PhamVanDe05/IOT_Clicker/README.md

# Classroom Clicker

Hệ thống trả lời trắc nghiệm trong lớp: sinh viên bấm đáp án trên tag cầm tay, giáo viên xem kết quả cả lớp ngay trên web.

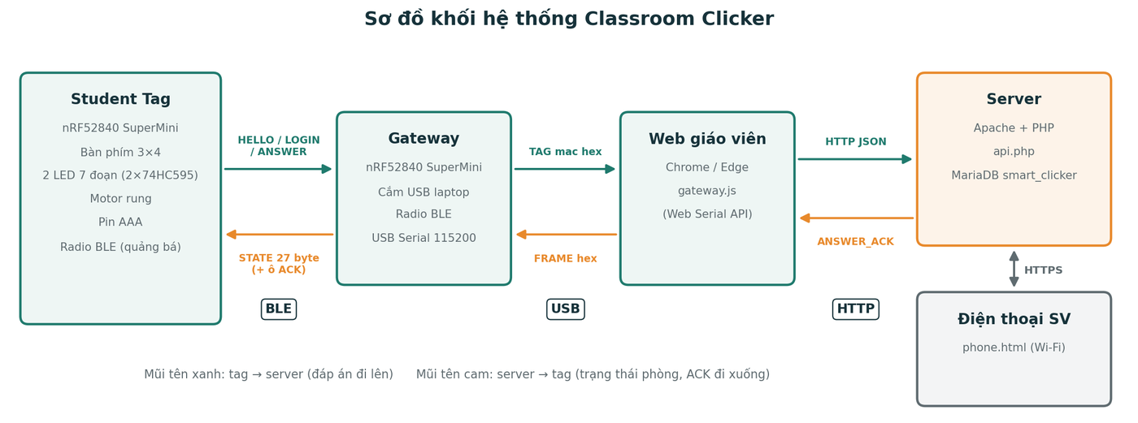
[picture p1: docs/images/so_do_khoi.png]
Sơ đồ khối


## Cách hoạt động

1. Tag bấm **OK** thì phát gói `ANSWER` qua BLE, phát lại liên tục tới khi nhận ACK.
2. Gateway nghe gói, chuyển lên web qua USB Serial.
3. Web (Chrome/Edge, Web Serial) gọi `api.php`.
4. Server **lưu database xong mới trả ACK**; gói trùng không bị ghi 2 lần.
5. ACK đi ngược xuống trong khung `STATE`; tag thấy đúng MAC của mình thì dừng phát và hiện `b=`.

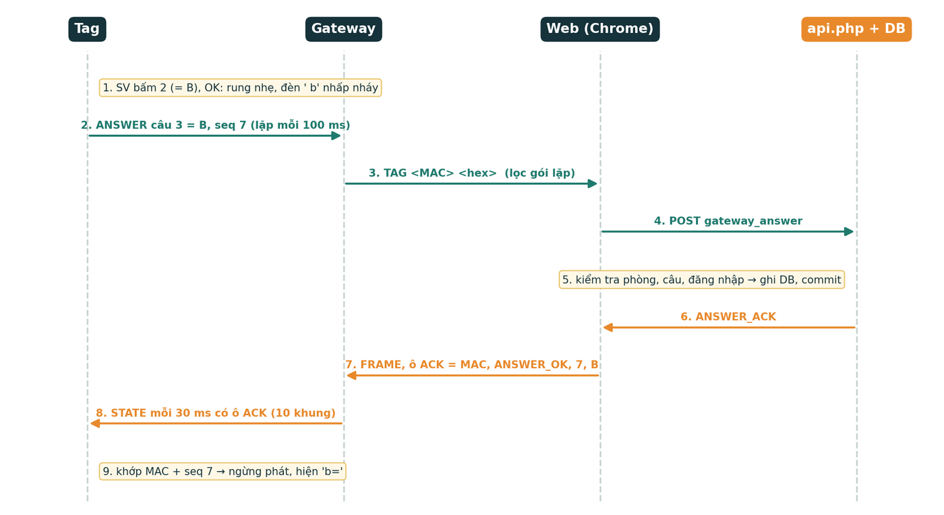
[picture p2: docs/images/so_do_ack.png]
Một câu trả lời và ACK


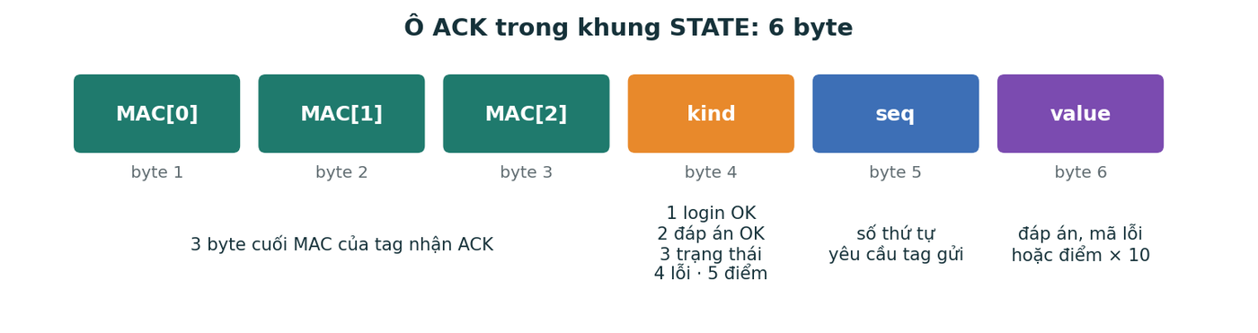
[picture p3: docs/images/ack_6_byte.png]
Ô ACK 6 byte


Định dạng từng byte: [`firmware/ClickerTag/protocol.h`](firmware/ClickerTag/protocol.h).

## Phần cứng

- **Tag:** nRF52840 SuperMini, bàn phím 3×4, 2 LED 7 đoạn qua 2×74HC595, motor rung, pin AAA.
- **Gateway:** nRF52840 SuperMini cắm USB laptop.

<table>
  <tr>
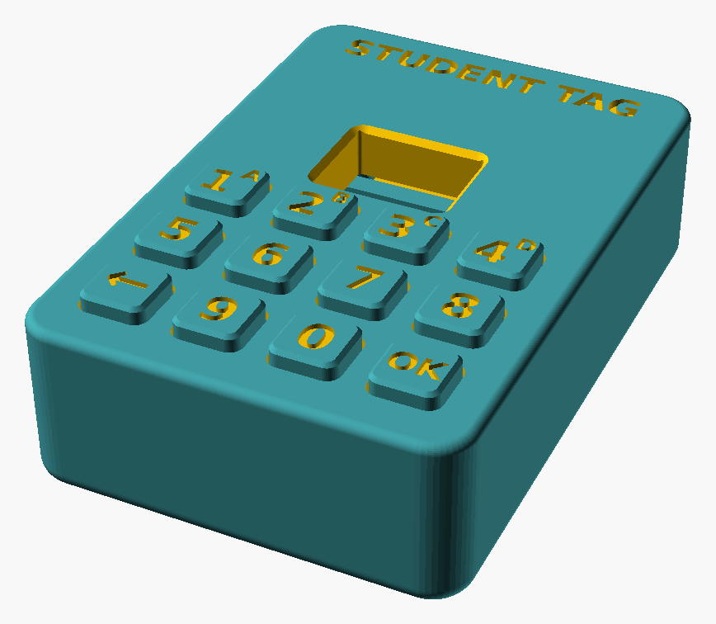
[picture p4: docs/images/tag_case.png]
    <td align="center"><br>Vỏ tag</td>
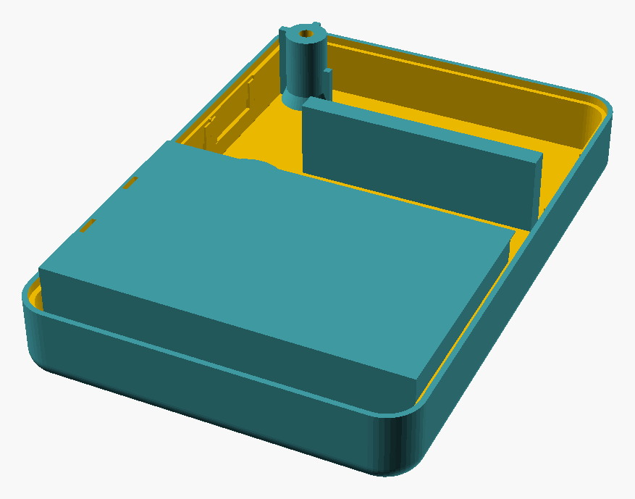
[picture p5: docs/images/tag_bottom.png]
    <td align="center"><br>Đáy tag</td>
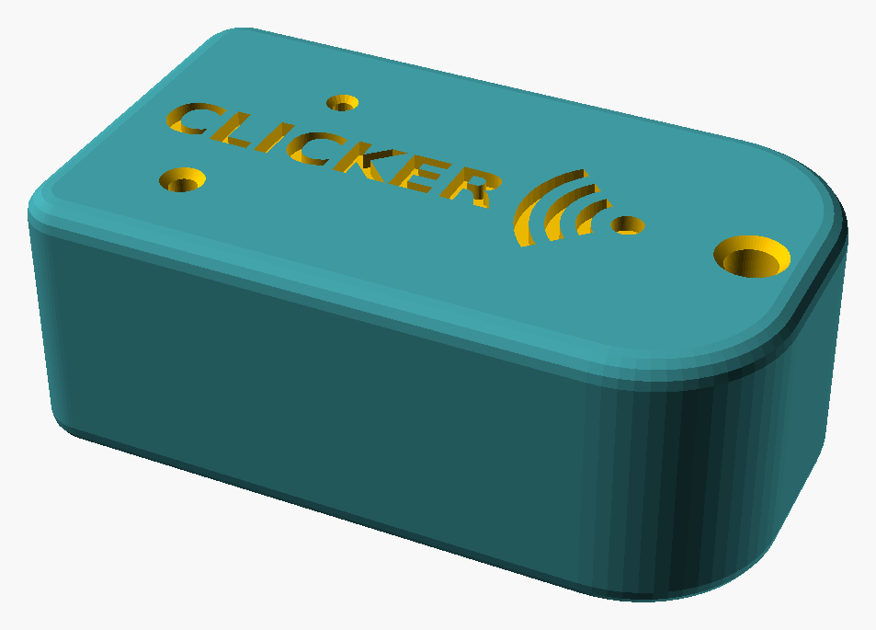
[picture p6: docs/images/gateway_case.png]
    <td align="center"><br>Vỏ gateway</td>
  </tr>
  <tr>
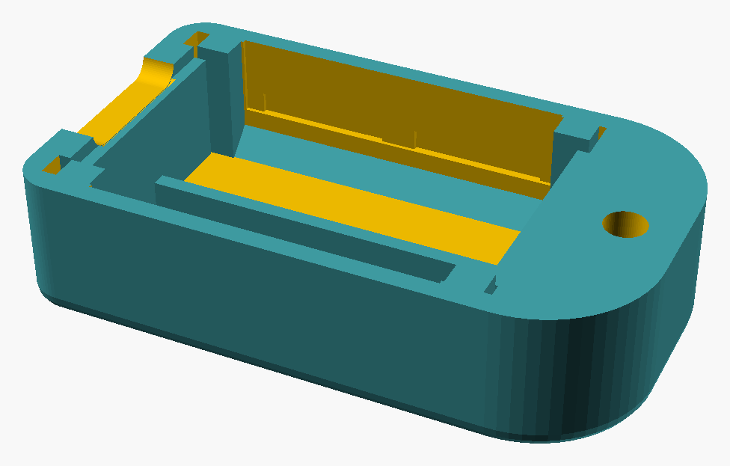
[picture p7: docs/images/gateway_bottom.png]
    <td align="center"><br>Đáy gateway</td>
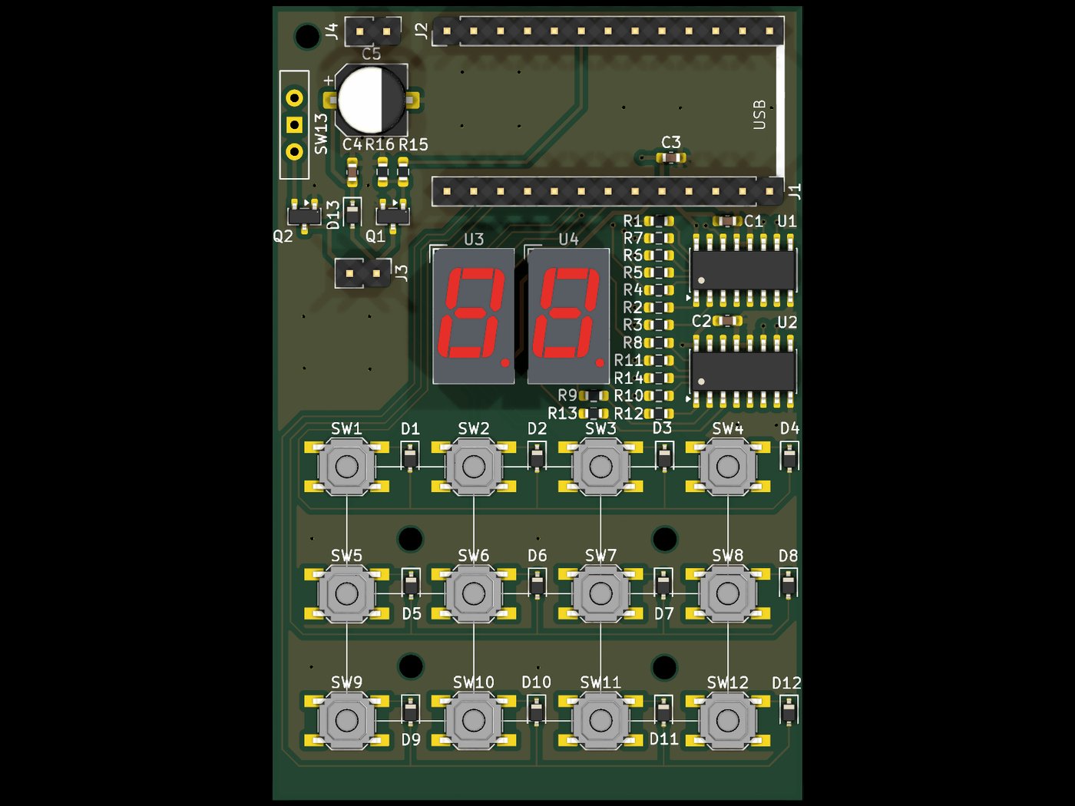
[picture p8: docs/images/pcb_top_3d.jpg]
    <td align="center"><br>PCB tag, mặt trên</td>
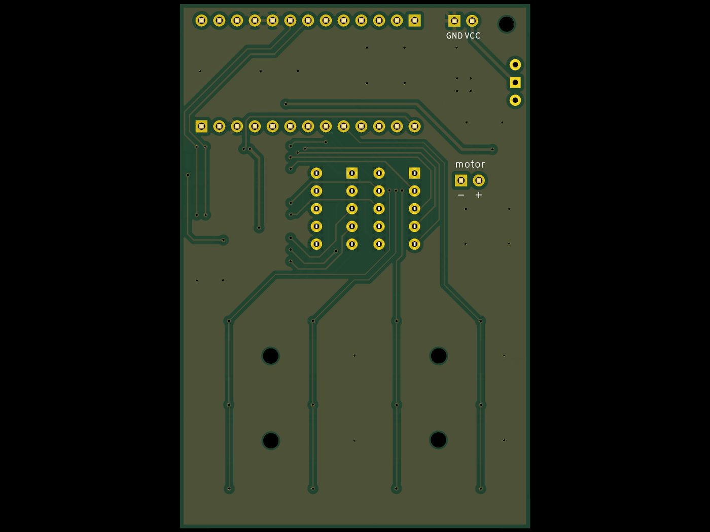
[picture p9: docs/images/pcb_bottom_3d.jpg]
    <td align="center"><br>PCB tag, mặt dưới</td>
  </tr>
  <tr>
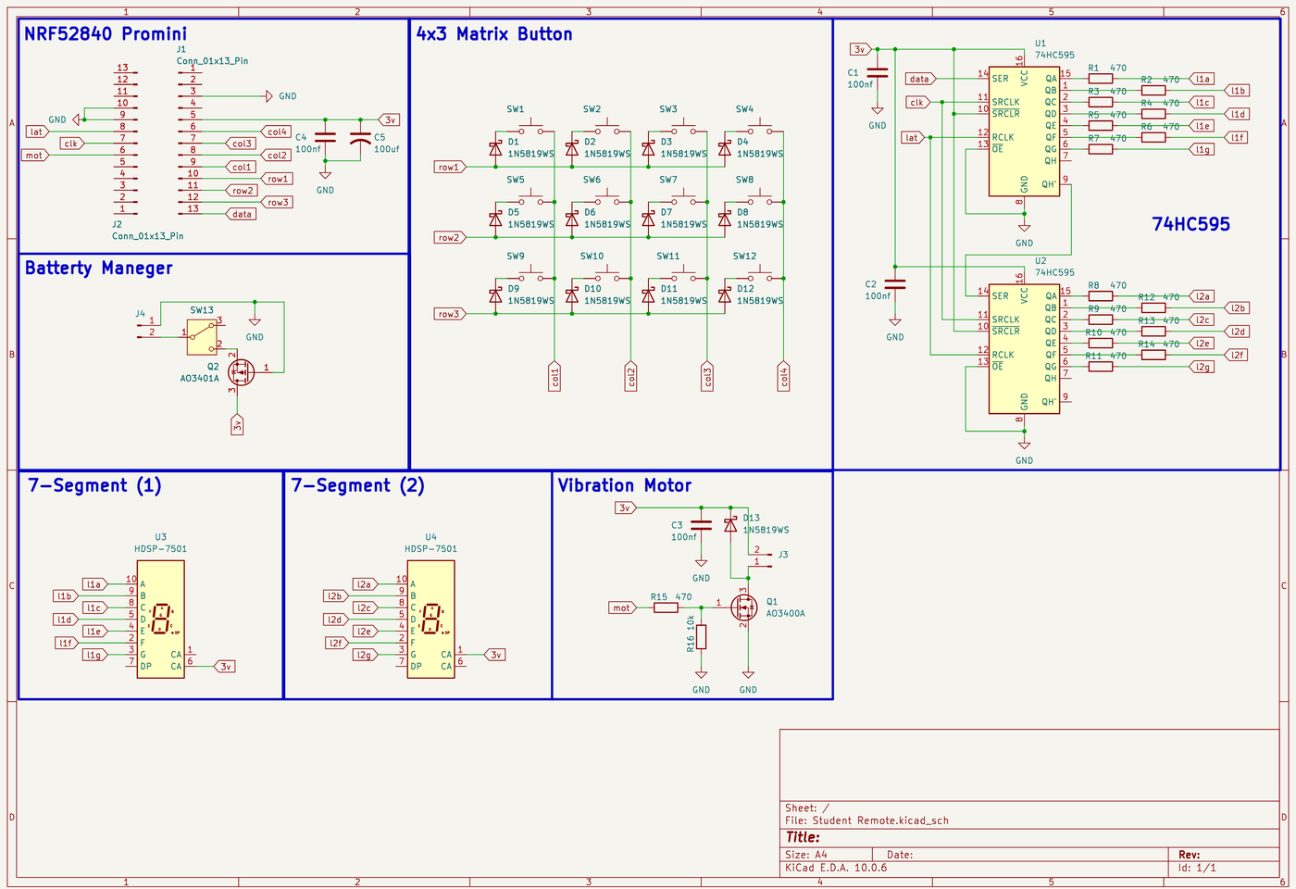
[picture p10: docs/images/schematic.png]
    <td colspan="3" align="center"><br>Sơ đồ nguyên lý</td>
  </tr>
</table>

### Màn hình tag trong một buổi

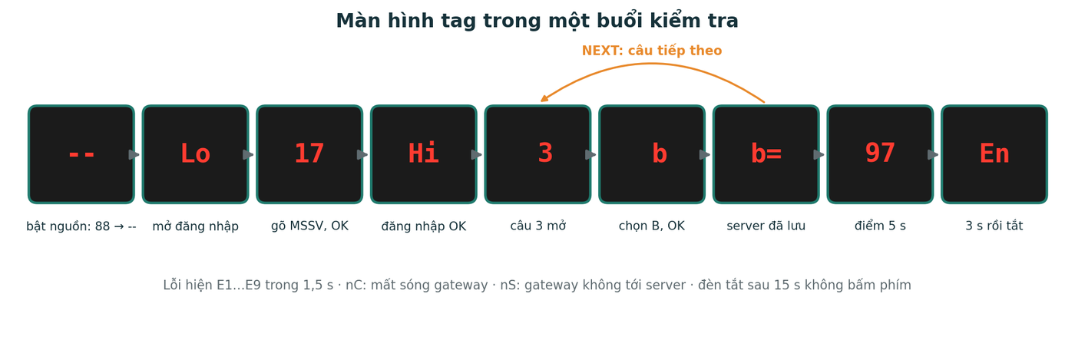
[picture p11: docs/images/luong_man_hinh_tag.png]
Luồng màn hình tag


Bảng mã đèn và mã lỗi đầy đủ: [docs/su_dung.md](docs/su_dung.md).

## Giao diện web

<table>
  <tr>
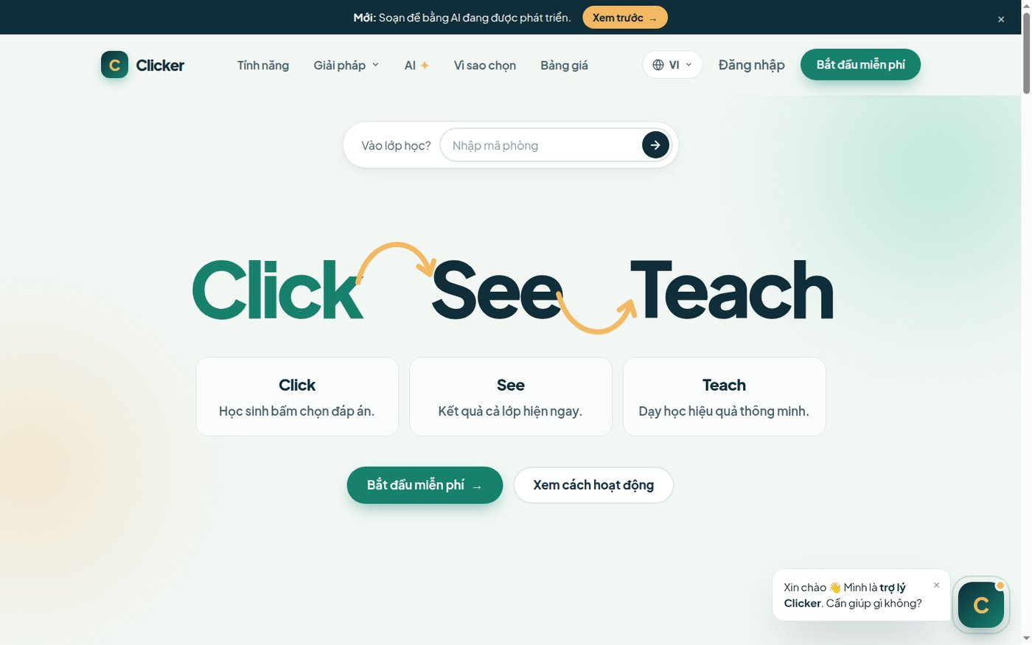
[picture p12: docs/images/landing.jpg]
    <td align="center"><br>Trang chủ</td>
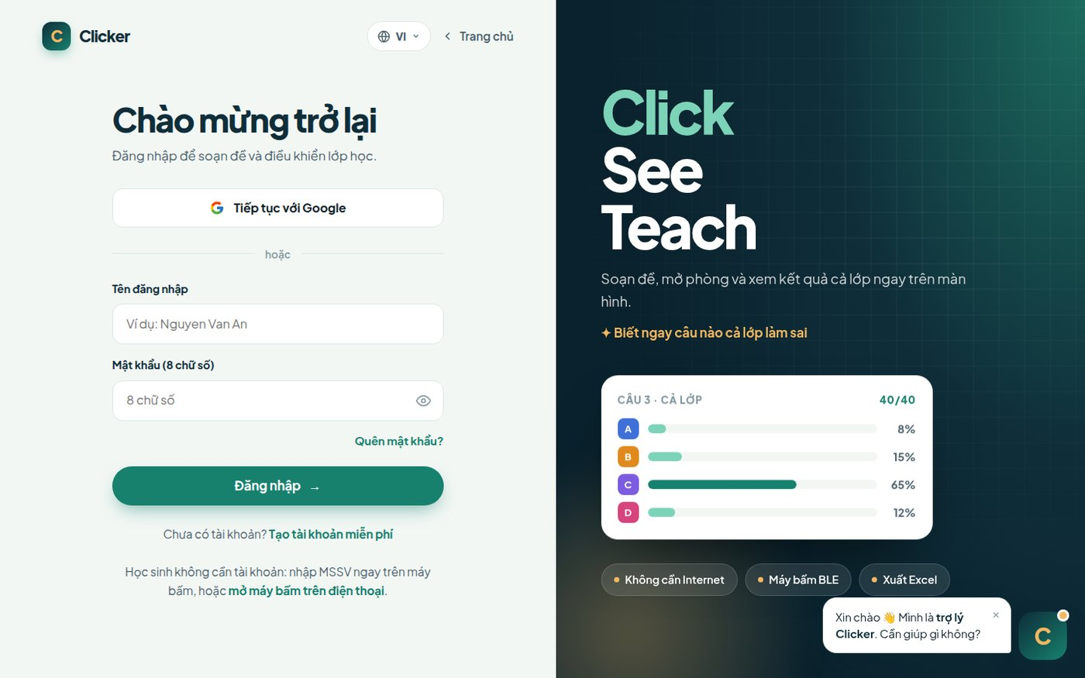
[picture p13: docs/images/login.jpg]
    <td align="center"><br>Đăng nhập</td>
  </tr>
  <tr>
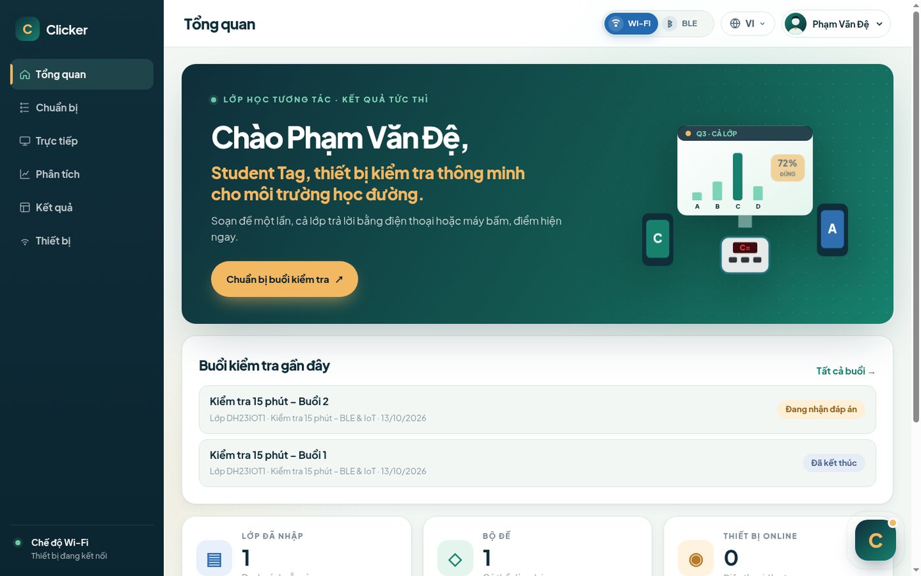
[picture p14: docs/images/overview.jpg]
    <td align="center"><br>Tổng quan</td>
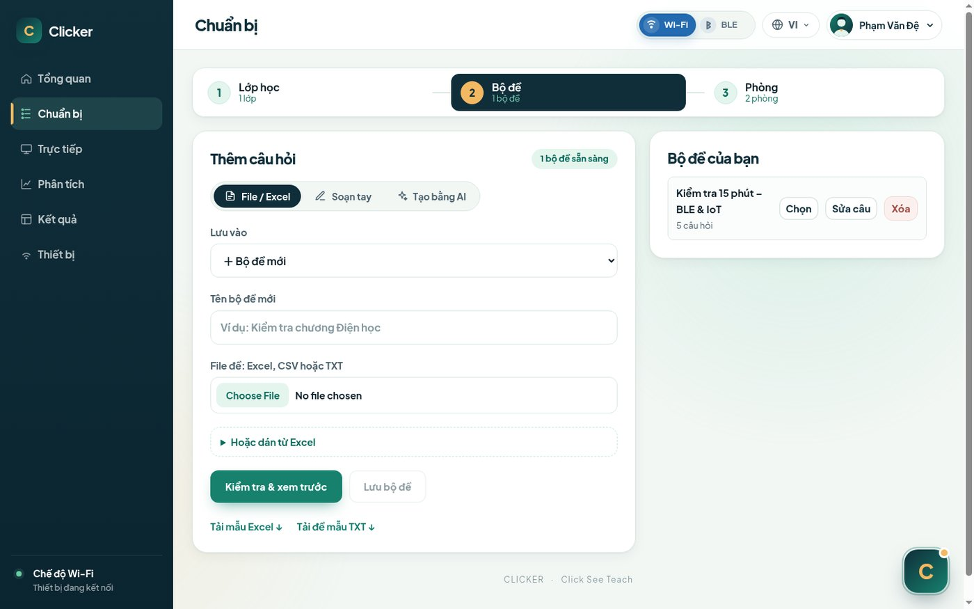
[picture p15: docs/images/prepare.jpg]
    <td align="center"><br>Chuẩn bị lớp và bộ đề</td>
  </tr>
  <tr>
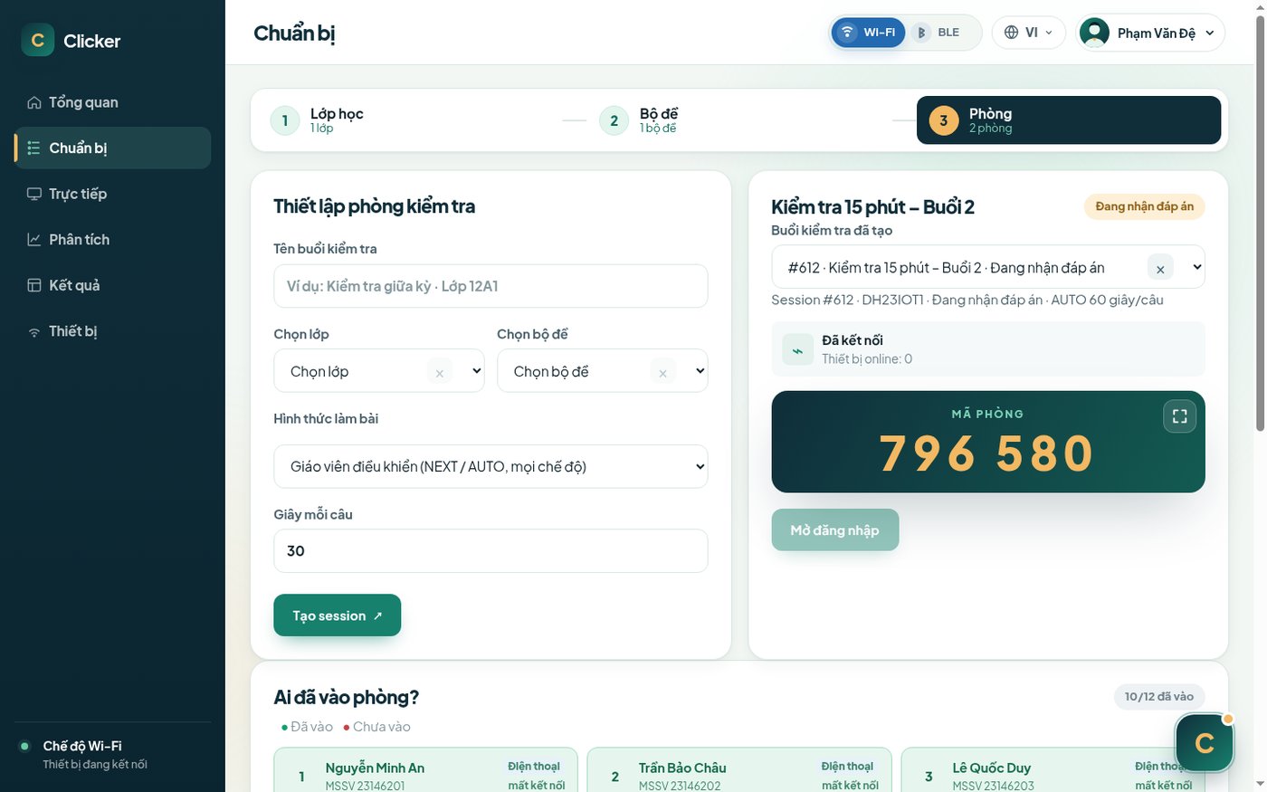
[picture p16: docs/images/room.jpg]
    <td align="center"><br>Tạo phòng, mã phòng</td>
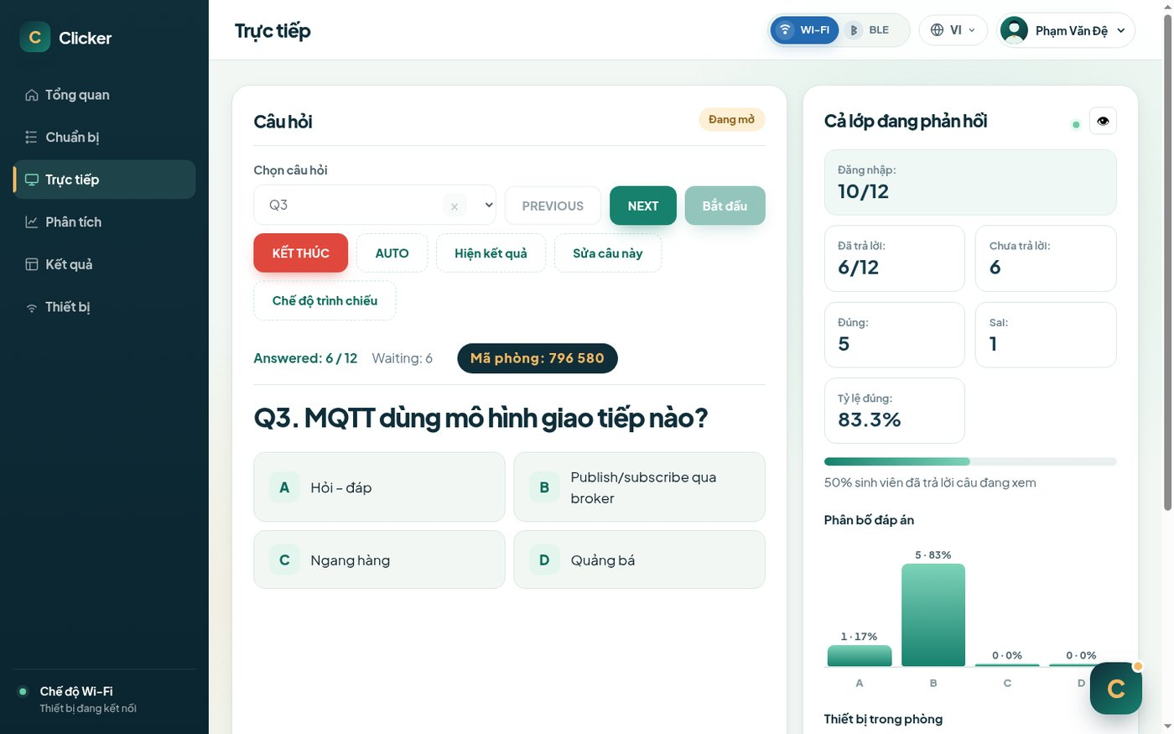
[picture p17: docs/images/live.jpg]
    <td align="center"><br>Trực tiếp: câu hỏi và biểu đồ đáp án</td>
  </tr>
  <tr>
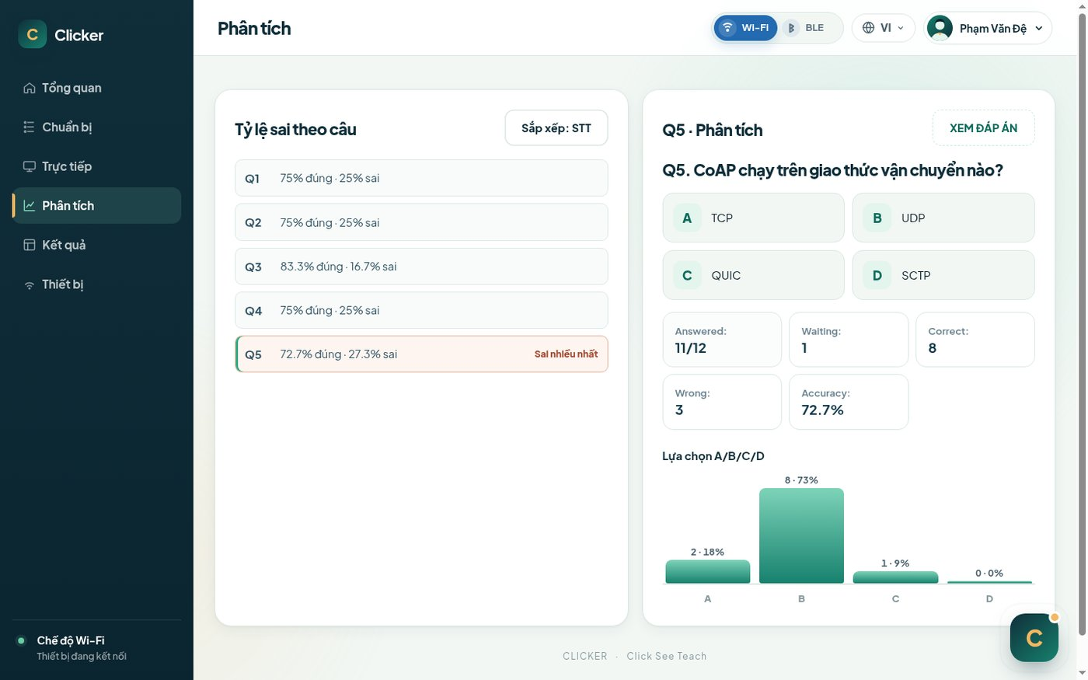
[picture p18: docs/images/analysis-section.jpg]
    <td align="center"><br>Phân tích câu hỏi</td>
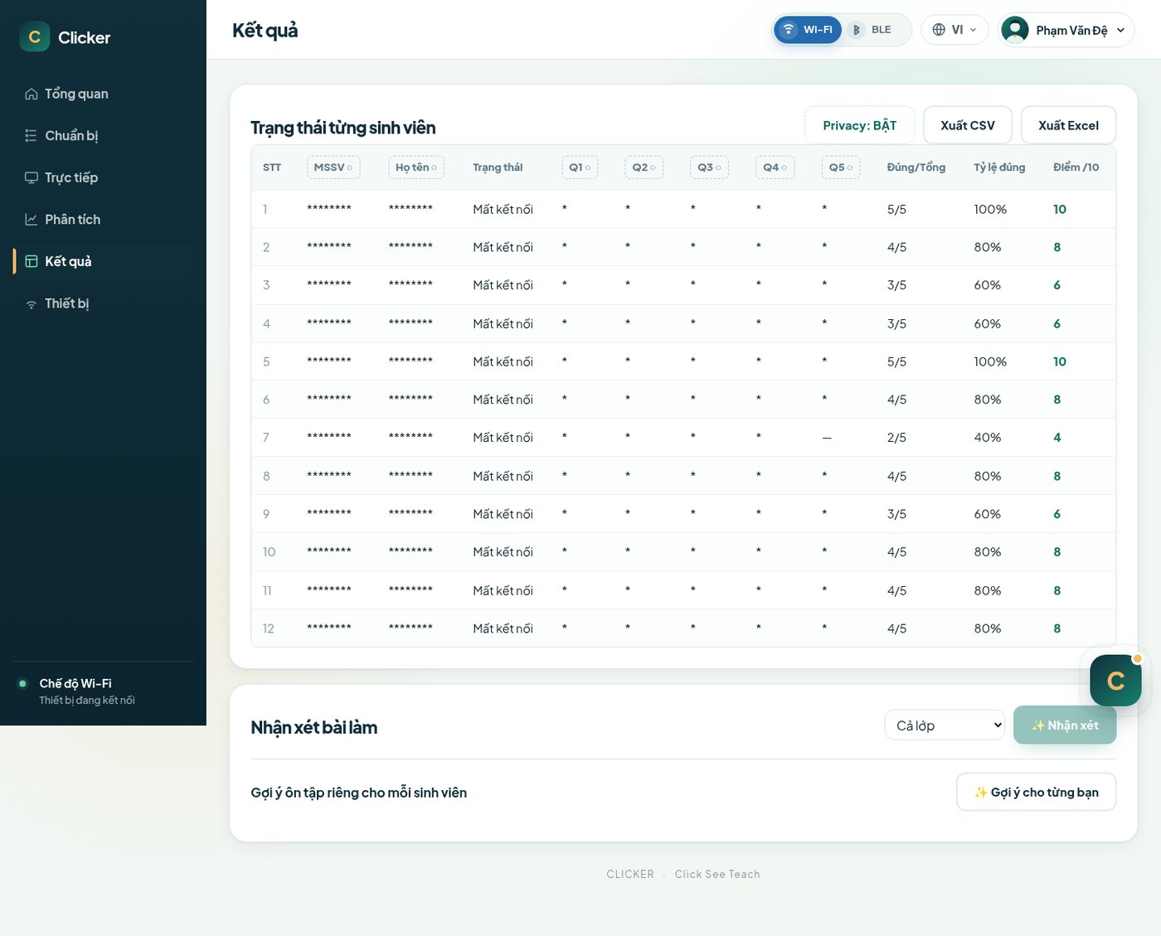
[picture p19: docs/images/results-section.jpg]
    <td align="center"><br>Bảng kết quả</td>
  </tr>
</table>

## Thư mục

| Thư mục | Nội dung |
|---|---|
| `web/` | Web giáo viên và API |
| `schema.sql` | Cấu trúc database |
| `config.example.php` | Mẫu file cấu hình |
| `examples/` | Danh sách lớp và đề mẫu |
| `firmware/ClickerTag/` | Firmware tag sinh viên |
| `firmware/ClickerGateway/` | Firmware gateway cắm USB laptop |
| `hardware/` | PCB (KiCad, Gerber, BOM) và vỏ in 3D tag, gateway |
| `docs/su_dung.md` | Hướng dẫn sử dụng, bảng mã đèn và mã lỗi |

## Cài đặt nhanh

**Server**

1. Import `schema.sql` vào MariaDB.
2. Chép `config.example.php` ra ngoài thư mục web, điền database và khóa; trỏ biến môi trường `CLICKER_CONFIG` tới file đó.
3. Đặt `web/` dưới Apache, mở <http://localhost/clicker/> bằng Chrome hoặc Edge.

**Firmware**: Arduino IDE, core **Adafruit nRF52**, board **Adafruit ItsyBitsy nRF52840 Express**. Nạp `firmware/ClickerTag/` vào tag, `firmware/ClickerGateway/` vào gateway.

Hướng dẫn một buổi kiểm tra: [docs/su_dung.md](docs/su_dung.md).
