PhamVanDe05/IOT_Clicker/web/landing/og.png

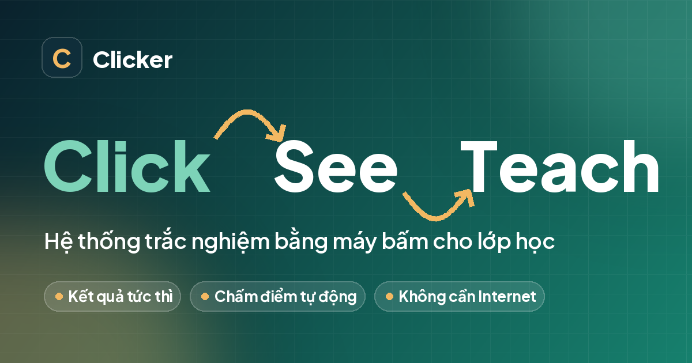
web/landing/og.png
