PhamVanDe05/IOT_Clicker/hardware/pcb/Student Remote.csv

Reference | Qty | Value | DNP | Exclude from BOM | Exclude from Board | Footprint | Datasheet
C1,C2,C3,C4 | 4 | 100nf |  |  |  | Capacitor_SMD:C_0603_1608Metric_Pad1.08x0.95mm_HandSolder | ~
C5 | 1 | 100uf |  |  |  | Capacitor_SMD:CP_Elec_6.3x5.4
D1,D2,D3,D4,D5,D6,D7,D8,D9,D10,D11,D12,D13 | 13 | 1N5819WS |  |  |  | Diode_SMD:D_SOD-323 | https://datasheet.lcsc.com/lcsc/2204281430_Guangdong-Hottech-1N5819WS_C191023.pdf
J1,J2 | 2 | Conn_01x13_Pin |  |  |  | Connector_PinHeader_2.54mm:PinHeader_1x13_P2.54mm_Vertical | ~
J3,J4 | 2 | Conn_01x02_Pin |  |  |  | Connector_PinHeader_2.54mm:PinHeader_1x02_P2.54mm_Vertical | ~
Q1 | 1 | AO3400A |  |  |  | Package_TO_SOT_SMD:SOT-23 | http://www.aosmd.com/pdfs/datasheet/AO3400A.pdf
Q2 | 1 | AO3401A |  |  |  | Package_TO_SOT_SMD:SOT-23 | http://www.aosmd.com/pdfs/datasheet/AO3401A.pdf
R1,R2,R3,R4,R5,R6,R7,R8,R9,R10,R11,R12,R13,R14,R15 | 15 | 470 |  |  |  | Resistor_SMD:R_0603_1608Metric_Pad0.98x0.95mm_HandSolder | ~
R16 | 1 | 10k |  |  |  | Resistor_SMD:R_0603_1608Metric_Pad0.98x0.95mm_HandSolder | ~
SW1,SW2,SW3,SW4,SW5,SW6,SW7,SW8,SW9,SW10,SW11,SW12 | 12 | SW_Push |  |  |  | Button_Switch_SMD:SW_SPST_SKQG_WithStem | ~
SW13 | 1 | SW_Wuerth_450301014042 |  |  |  | Button_Switch_THT:SW_Slide-03_Wuerth-WS-SLTV_10x2.5x6.4_P2.54mm | https://www.we-online.com/components/products/datasheet/450301014042.pdf
U1,U2 | 2 | 74HC595 |  |  |  | Package_SO:SOIC-16_3.9x9.9mm_P1.27mm | http://www.ti.com/lit/ds/symlink/sn74hc595.pdf
U3,U4 | 2 | HDSP-7501 |  |  |  | Display_7Segment:HDSP-A151 | https://docs.broadcom.com/docs/AV02-2553EN
