PhamVanDe05/IOT_Clicker/hardware/case/gateway/step/gateway_lap-rap.step

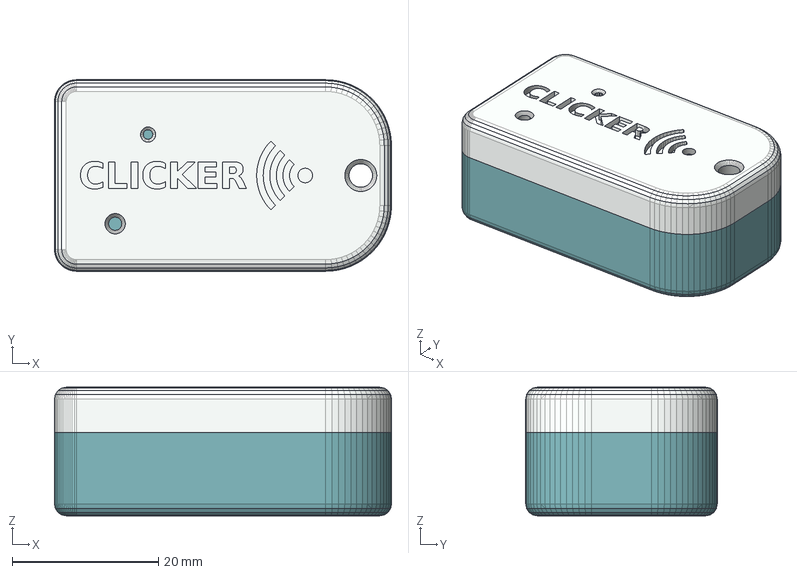
[picture p21: CAD file, 2026-10-13]
hardware/case/gateway/step/gateway_lap-rap.step
46.1 x 26.2 x 17.6 mm
