PhamVanDe05/IOT_Clicker/hardware/case/gateway/stl/nua-tren.stl

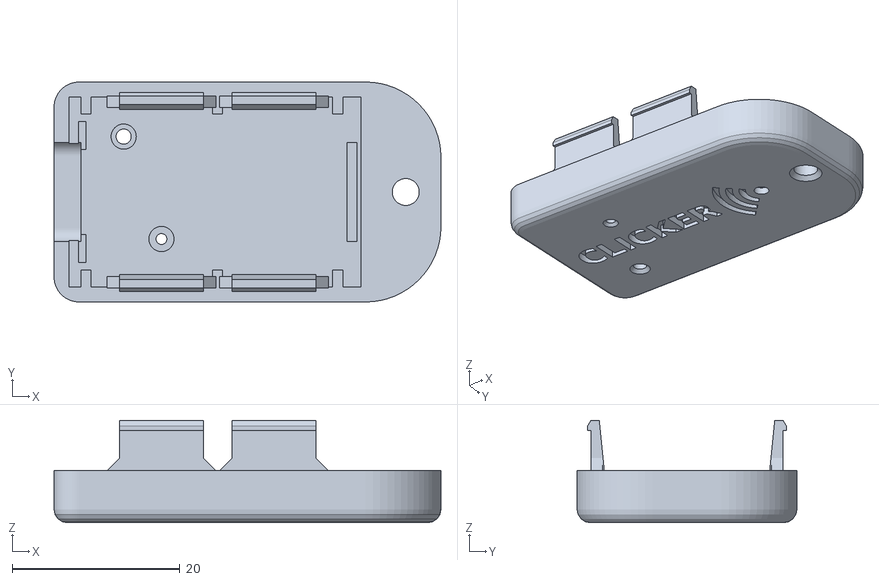
[picture p22: CAD file, 2026-10-13]
hardware/case/gateway/stl/nua-tren.stl
46.1 x 26.2 x 12.2
