PhamVanDe05/IOT_Clicker/hardware/case/tag/step/student_tag_board_kicad.step

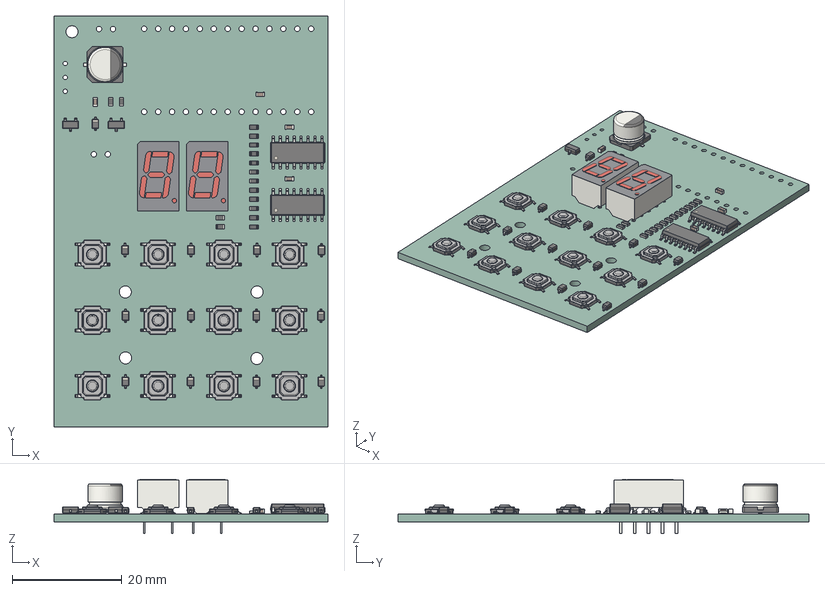
[picture p23: CAD file, 2026-10-10]
hardware/case/tag/step/student_tag_board_kicad.step
50.0 x 75.0 x 9.90 mm
SOT-23 x 2
C_0603_1608Metric x 4
R_0603_1608Metric x 16
CP_Elec_63x54
SOIC-16_3.9x9.9mm_P1.27mm x 2
SW_SPST_SKQG_WithStem x 12
D_SOD-323 x 13
HDSP-A151 x 2
Student Remote_PCB
