PhamVanDe05/IOT_Clicker/hardware/case/tag/stl/phim_2B.stl

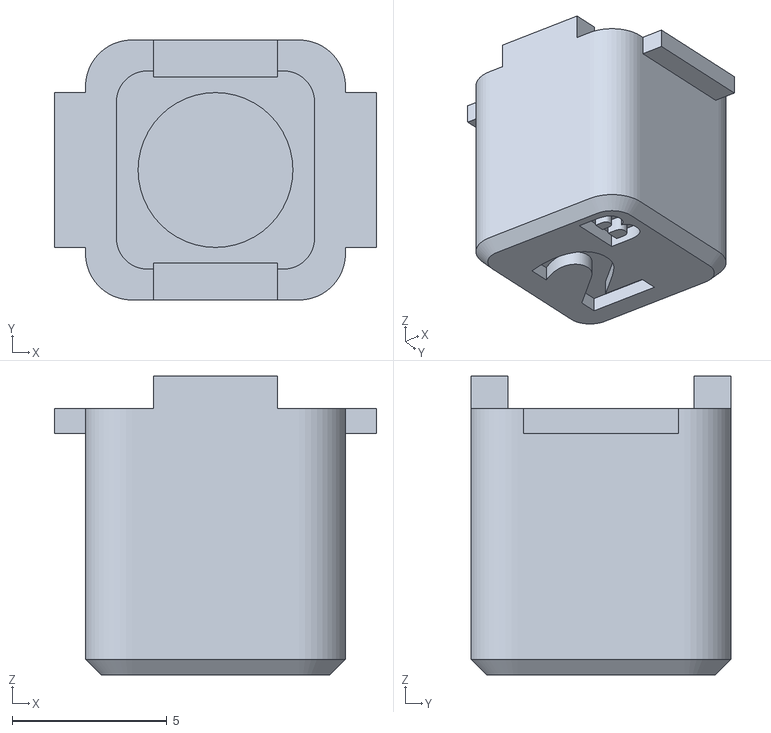
[picture p24: CAD file, 2026-10-10]
hardware/case/tag/stl/phim_2B.stl
10.4 x 8.40 x 9.65
