PhamVanDe05/IOT_Clicker/hardware/case/gateway/stl/nua-duoi.stl

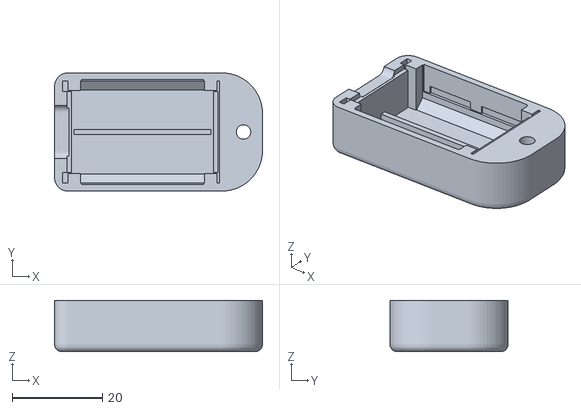
[picture p25: CAD file, 2026-10-10]
hardware/case/gateway/stl/nua-duoi.stl
46.1 x 26.2 x 11.4
