PhamVanDe05/IOT_Clicker/hardware/case/tag/step/student_tag_v3_nap-pin.step

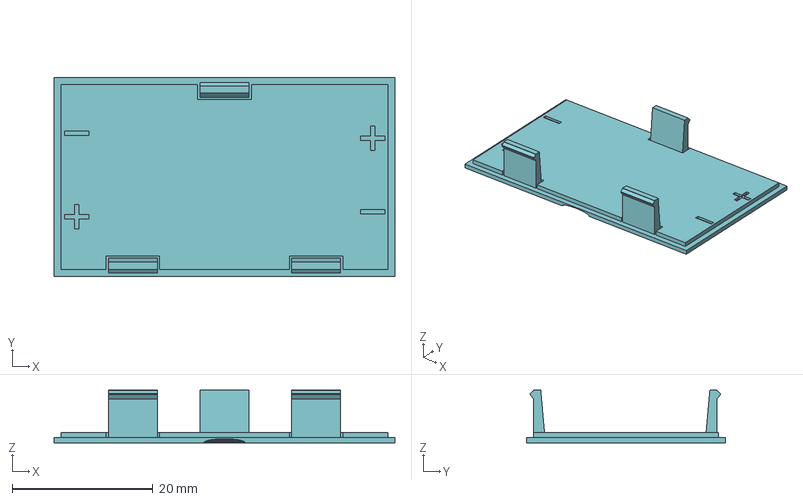
[picture p26: CAD file, 2026-10-10]
hardware/case/tag/step/student_tag_v3_nap-pin.step
48.4 x 28.2 x 7.50 mm
