PhamVanDe05/IOT_Clicker/hardware/case/tag/stl/vo-tren.stl

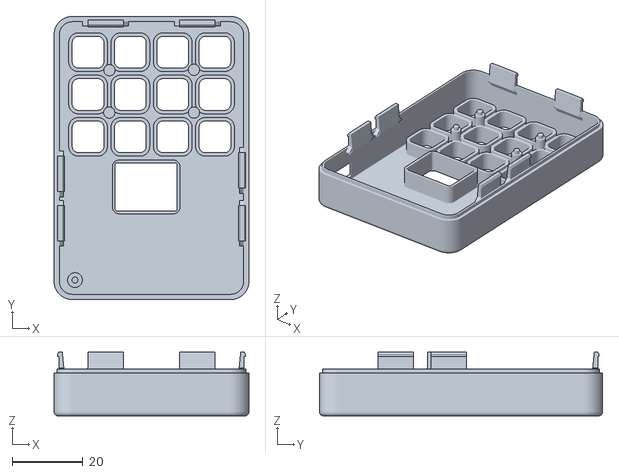
[picture p27: CAD file, 2026-10-10]
hardware/case/tag/stl/vo-tren.stl
55.3 x 80.3 x 18.1
