PhamVanDe05/IOT_Clicker/hardware/case/tag/step/student_tag_v3_vo-duoi.step

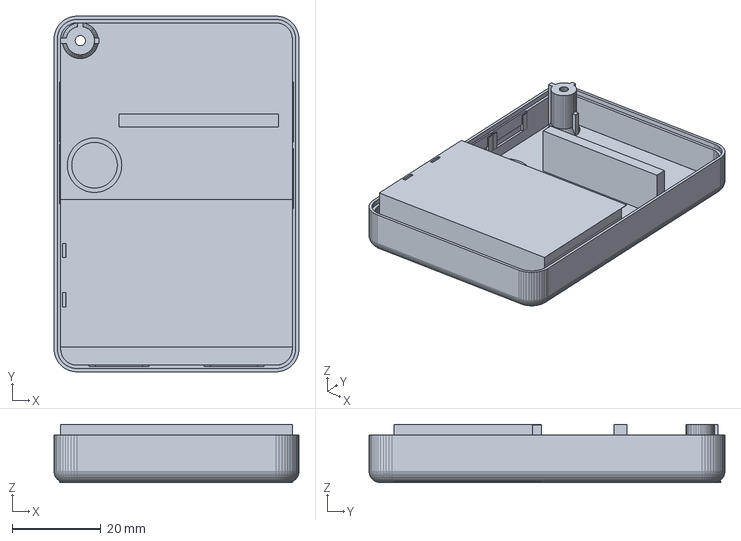
[picture p28: CAD file, 2026-10-10]
hardware/case/tag/step/student_tag_v3_vo-duoi.step
55.3 x 80.3 x 13.1 mm
