PhamVanDe05/IOT_Clicker/hardware/case/tag/step/student_tag_v3_vo-lap-rap.step

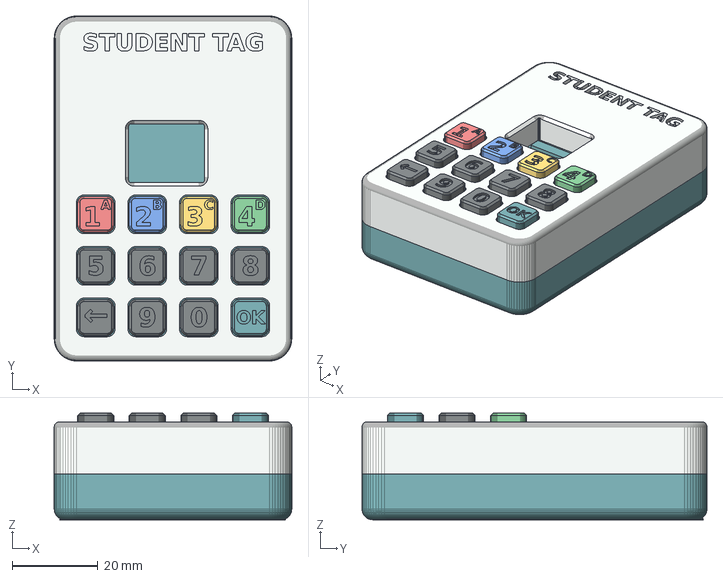
[picture p29: CAD file, 2026-10-10]
hardware/case/tag/step/student_tag_v3_vo-lap-rap.step
55.3 x 80.3 x 24.8 mm
