PhamVanDe05/IOT_Clicker/hardware/case/tag/stl/phim_BACK.stl

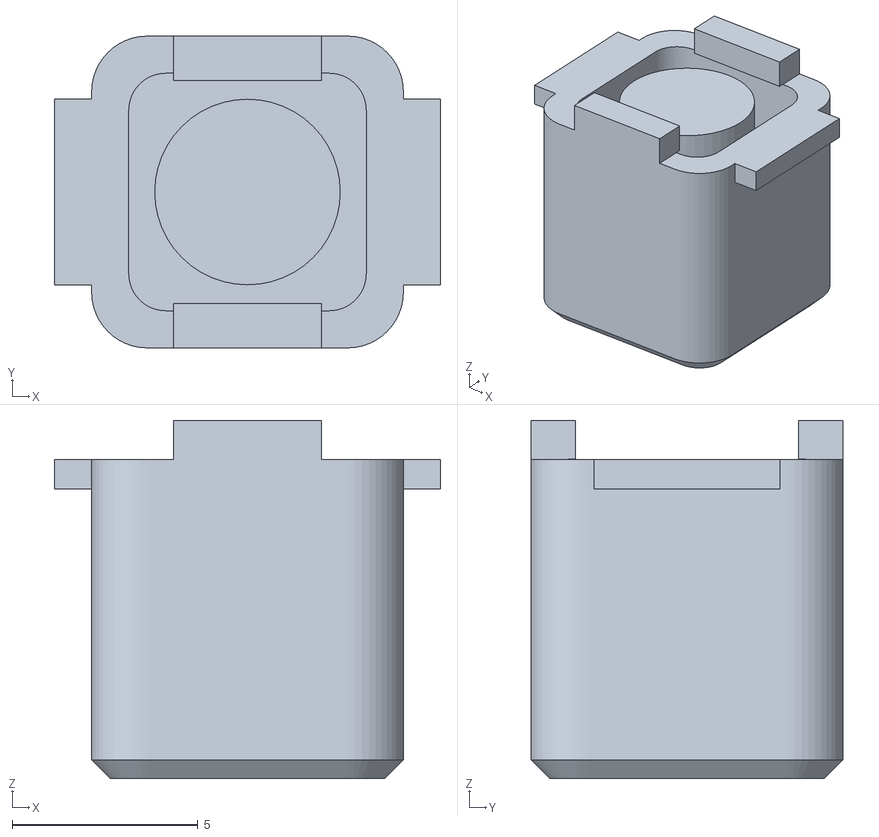
[picture p30: CAD file, 2026-10-10]
hardware/case/tag/stl/phim_BACK.stl
10.4 x 8.40 x 9.65
