PhamVanDe05/IOT_Clicker/hardware/case/tag/step/student_tag_v3_phim.step

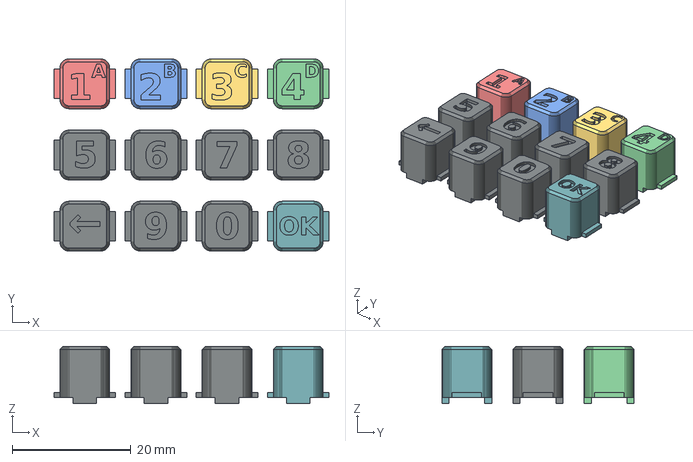
[picture p31: CAD file, 2026-10-10]
hardware/case/tag/step/student_tag_v3_phim.step
46.4 x 32.4 x 9.65 mm
