PhamVanDe05/IOT_Clicker/(list of files, cad)

Other CAD files:
hardware/case/gateway/step/gateway_nua-tren.step
hardware/case/gateway/step/gateway_nua-duoi.step
hardware/case/tag/stl/phim_OK.stl
hardware/case/tag/step/student_tag_v3_vo-tren.step
hardware/case/tag/stl/phim_5.stl
hardware/case/tag/stl/phim_9.stl
hardware/case/tag/stl/phim_8.stl
hardware/case/tag/stl/phim_6.stl
hardware/case/tag/stl/phim_4D.stl
hardware/case/tag/stl/phim_1A.stl
hardware/case/tag/stl/phim_7.stl
hardware/case/tag/stl/phim_0.stl
hardware/case/tag/stl/vo-duoi.stl
hardware/case/tag/stl/phim_3C.stl
hardware/case/tag/stl/nap-pin.stl
