PhamVanDe05/IOT_Clicker/hardware/pcb/Student Remote.kicad_pcb

## KiCad design hardware/pcb/Student Remote.kicad_pcb (2026-10-12)

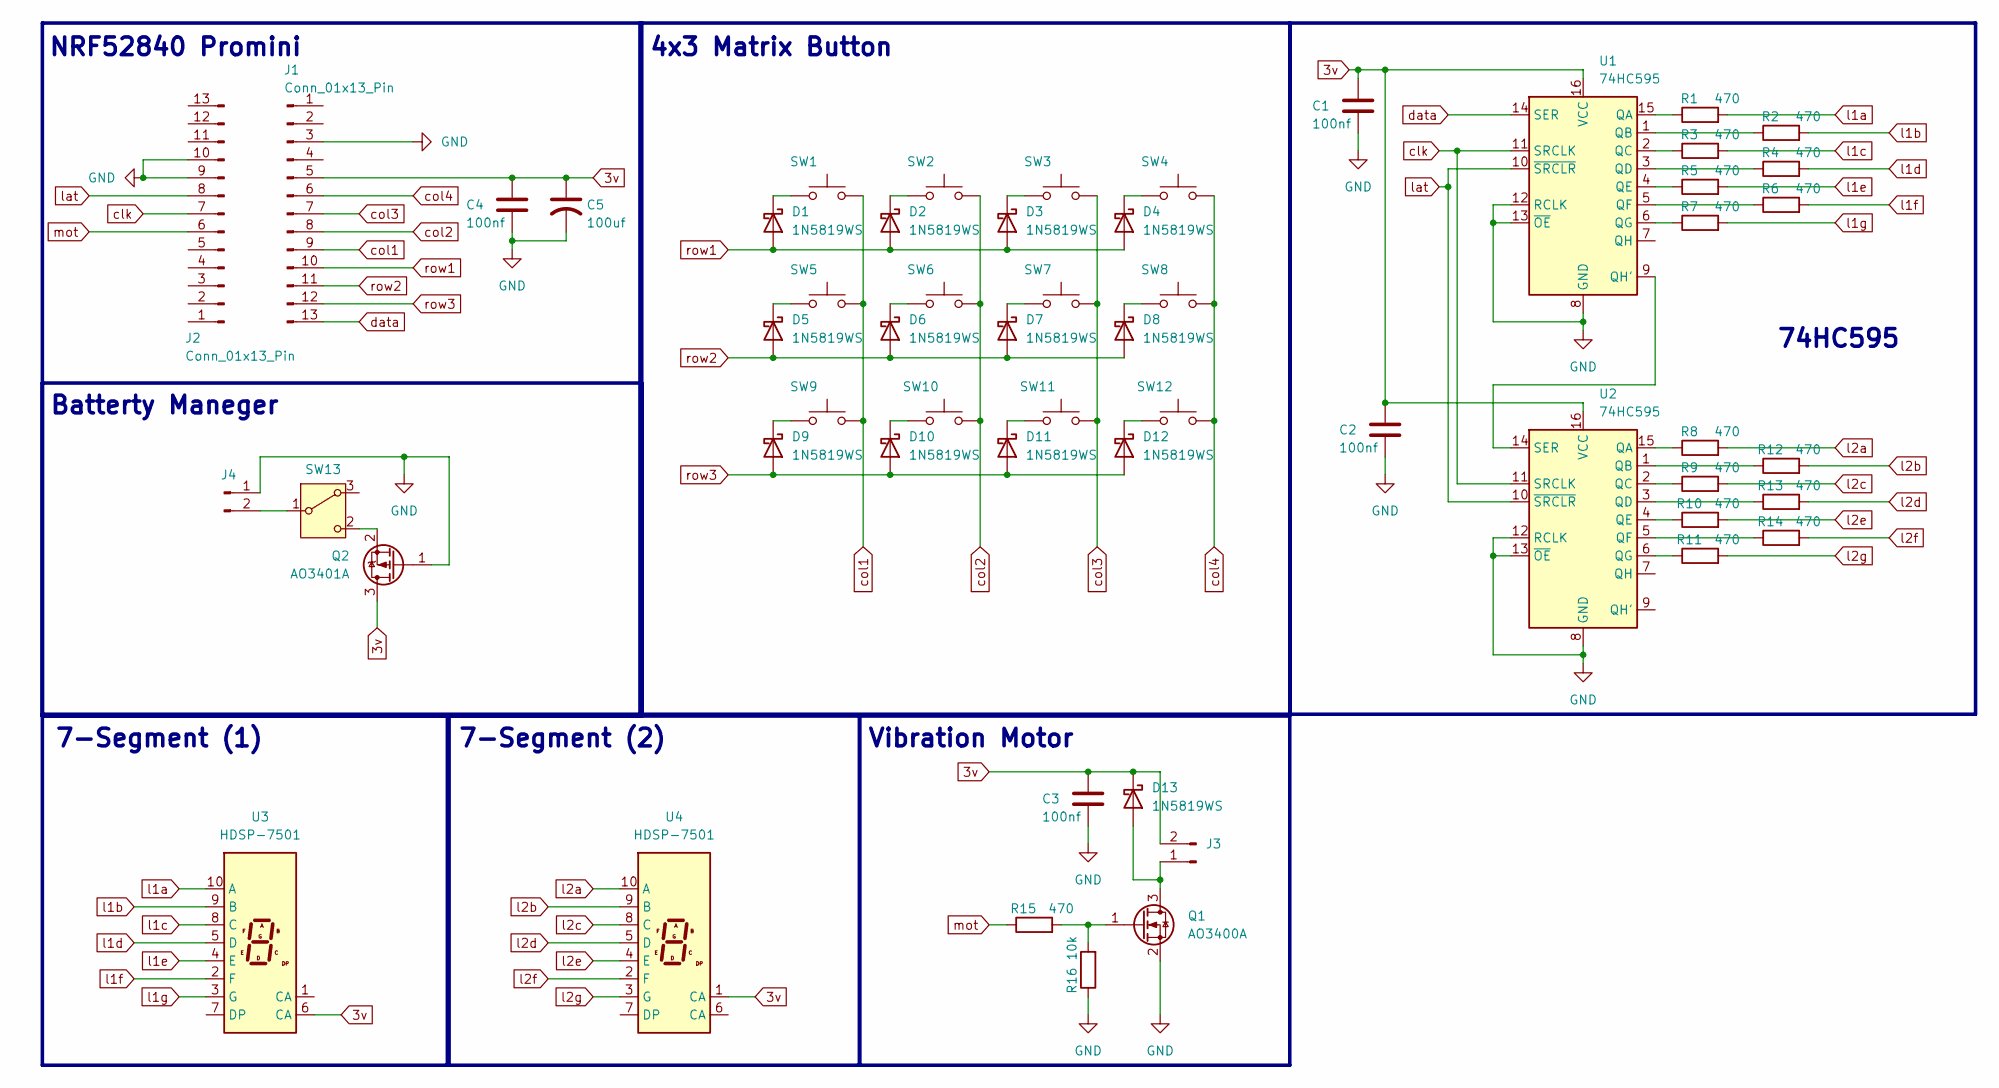
[picture p32: schematic Student Remote.kicad_sch]

Parts:
C1, C2, C3, C4: 100nf; C_0603_1608Metric_Pad1.08x0.95mm_HandSolder
C5: 100uf; CP_Elec_6.3x5.4
D1, D2, D3, D4, D5, D6, D7, D8, D9, D10, D11, D12, D13: 1N5819WS; D_SOD-323
J1, J2: Conn_01x13_Pin; PinHeader_1x13_P2.54mm_Vertical
J3, J4: Conn_01x02_Pin; PinHeader_1x02_P2.54mm_Vertical
Q1: AO3400A; SOT-23
Q2: AO3401A; SOT-23
R1, R2, R3, R4, R5, R6, R7, R8, R9, R10, R11, R12, R13, R14, R15: 470; R_0603_1608Metric_Pad0.98x0.95mm_HandSolder
R16: 10k; R_0603_1608Metric_Pad0.98x0.95mm_HandSolder
SW1, SW2, SW3, SW4, SW5, SW6, SW7, SW8, SW9, SW10, SW11, SW12: SW_Push; SW_SPST_SKQG_WithStem
SW13: SW_Wuerth_450301014042; SW_Slide-03_Wuerth-WS-SLTV_10x2.5x6.4_P2.54mm
U1, U2: 74HC595; SOIC-16_3.9x9.9mm_P1.27mm
U3, U4: HDSP-7501; HDSP-A151

Connections:
3v: C1.1, C2.1, C3.1, C4.1, C5.1, D13.1 (K), J1.5, J3.2, Q2.3 (D), U1.16 (VCC), U2.16 (VCC), U3.6 (CA), U4.1 (CA)
GND: C1.2, C2.2, C3.2, C4.2, C5.2, J1.3, J2.9, J2.10, J4.1, Q1.2 (S), Q2.1 (G), R16.1, U1.8 (GND), U1.12 (RCLK), U1.13 (~OE), U2.8 (GND), U2.12 (RCLK), U2.13 (~OE)
unnamed: D1.1 (K), SW1.1
unnamed: D2.1 (K), SW2.1
unnamed: D3.1 (K), SW3.1
unnamed: D4.1 (K), SW4.1
unnamed: D5.1 (K), SW5.1
unnamed: D6.1 (K), SW6.1
unnamed: D7.1 (K), SW7.1
unnamed: D8.1 (K), SW8.1
unnamed: D9.1 (K), SW9.1
unnamed: D10.1 (K), SW10.1
unnamed: D11.1 (K), SW11.1
unnamed: D12.1 (K), SW12.1
unnamed: D13.2 (A), J3.1, Q1.3 (D)
unnamed: J4.2, SW13.1 (B)
unnamed: Q1.1 (G), R15.2, R16.2
unnamed: Q2.2 (S), SW13.2 (C)
unnamed: R1.1, U1.15 (QA)
unnamed: R2.1, U1.1 (QB)
unnamed: R3.1, U1.2 (QC)
unnamed: R4.1, U1.3 (QD)
unnamed: R5.1, U1.4 (QE)
unnamed: R6.1, U1.5 (QF)
unnamed: R7.1, U1.6 (QG)
unnamed: U1.9 (QH'), U2.14 (SER)
unnamed: R8.1, U2.15 (QA)
unnamed: R12.1, U2.1 (QB)
unnamed: R9.1, U2.2 (QC)
unnamed: R13.1, U2.3 (QD)
unnamed: R10.1, U2.4 (QE)
unnamed: R14.1, U2.5 (QF)
unnamed: R11.1, U2.6 (QG)
clk: J2.7, U1.11 (SRCLK), U2.11 (SRCLK)
col1: J1.9, SW1.2, SW5.2, SW9.2
col2: J1.8, SW2.2, SW6.2, SW10.2
col3: J1.7, SW3.2, SW7.2, SW11.2
col4: J1.6, SW4.2, SW8.2, SW12.2
data: J1.13, U1.14 (SER)
l1a: R1.2, U3.10 (A)
l1b: R2.2, U3.9 (B)
l1c: R3.2, U3.8 (C)
l1d: R4.2, U3.5 (D)
l1e: R5.2, U3.4 (E)
l1f: R6.2, U3.2 (F)
l1g: R7.2, U3.3 (G)
l2a: R8.2, U4.10 (A)
l2b: R12.2, U4.9 (B)
l2c: R9.2, U4.8 (C)
l2d: R13.2, U4.5 (D)
l2e: R10.2, U4.4 (E)
l2f: R14.2, U4.2 (F)
l2g: R11.2, U4.3 (G)
lat: J2.8, U1.10 (~SRCLR), U2.10 (~SRCLR)
mot: J2.6, R15.1
row1: D1.2 (A), D2.2 (A), D3.2 (A), D4.2 (A), J1.10
row2: D5.2 (A), D6.2 (A), D7.2 (A), D8.2 (A), J1.11
row3: D9.2 (A), D10.2 (A), D11.2 (A), D12.2 (A), J1.12

Notes on the sheet:
Batterty Maneger
74HC595
4x3 Matrix Button
NRF52840 Promini
7-Segment (2)
7-Segment (1)
Vibration Motor

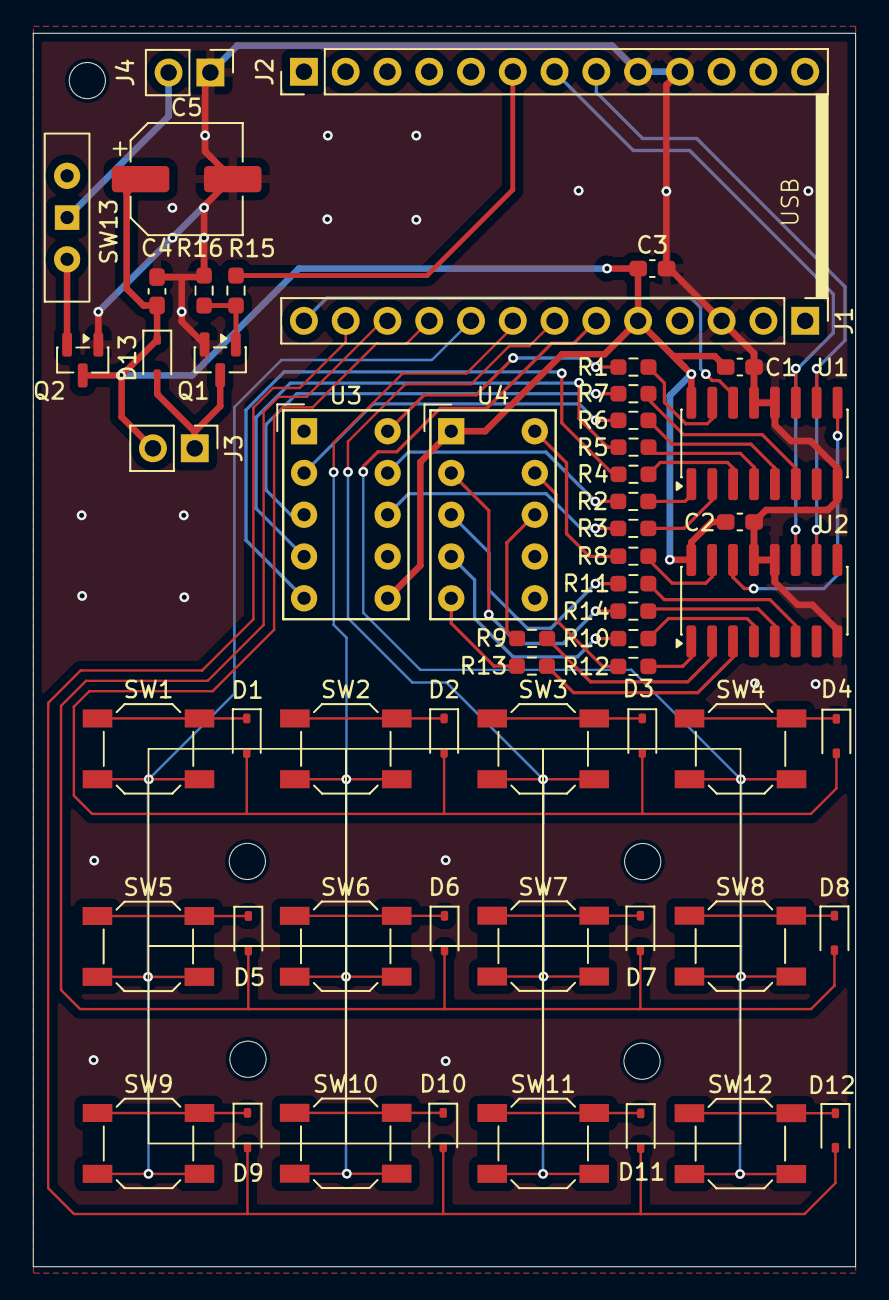
[picture p33: board Student Remote.kicad_pcb from above]

Board: 2 copper layers, 50.0 x 75.0 mm, 57 parts (0 on the bottom side), 58 nets.
