PhamVanDe05/IOT_Clicker/(commit log)

2026-10-10 Classroom Clicker: web, tag and gateway firmware, PCB, 3D cases, docs
    [Student Remote-B_Cu.gbr, Student Remote-B_Mask.gbr, Student Remote-B_Silkscreen.gbr, Student Remote-Edge_Cuts.gbr, Student Remote-F_Cu.gbr, Student Remote-F_Mask.gbr, Student Remote-F_Silkscreen.gbr, Student Remote-NPTH.drl]
2026-10-12 Full project: multi-room web, tag score display, gateway, hardware, docs, tests
    [BOM Student Tag Respond.xlsx, DH22IOT1.csv, DH22IOT2.csv, DH23DT1.csv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]
2026-10-13 Keep only what is needed: web, schema, tag and gateway firmware, hardware, user guide
    [BOM Student Tag Respond.xlsx, DH22IOT1.csv, DH22IOT2.csv, DH23DT1.csv, Student Remote.step, StudentTag.kicad_pcb, StudentTag.kicad_sch, StudentTag_BOM.csv]
2026-10-13 Add STEP files of the tag and gateway cases
    [gateway_lap-rap.step, gateway_nua-duoi.step, gateway_nua-tren.step, student_tag_board_kicad.step, student_tag_v3_nap-pin.step, student_tag_v3_phim.step, student_tag_v3_vo-duoi.step, student_tag_v3_vo-lap-rap.step]
2026-10-13 Web: phòng chờ chiếu TV có QR, hiệu ứng đáp án, AI tạo đề, gợi ý ôn tập, tag mô phỏng trên điện thoại
2026-10-13 Schematic: 74HC595 pin 12 RCLK to lat, pin 10 SRCLR to 3V
    [Student Remote.kicad_sch]
2026-10-13 Schematic: redrawn 74HC595 wiring
    [Student Remote.kicad_sch]
2026-10-13 Gateway case: CLICKER text no longer overlaps the logo
    [gateway_case.scad, gateway_lap-rap.step, gateway_nua-tren.step, nua-tren.stl]
